jacky4566/KTM1190CruiseController/Pictures/790 Cruise Pinout.jpg

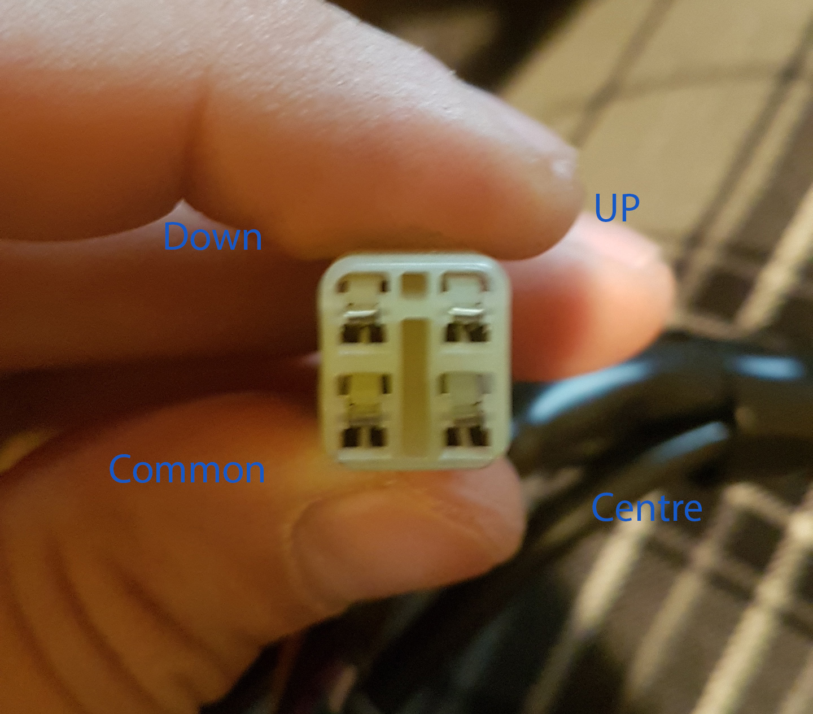
Pictures/790 Cruise Pinout.jpg
