jacky4566/KTM1190CruiseController/Data Sheets/IC/2017-01-09T04_01_26.198Z-Butterfly.sch.png

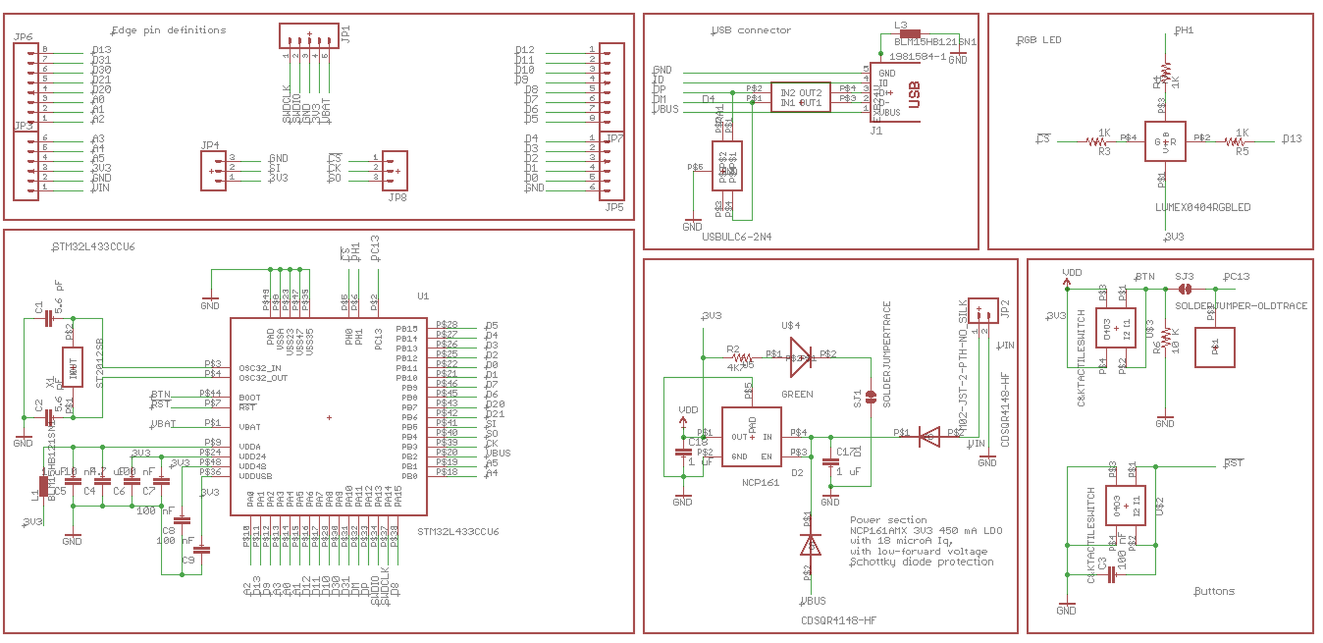
Data Sheets/IC/2017-01-09T04_01_26.198Z-Butterfly.sch.png
