jacky4566/KTM1190CruiseController/Data Sheets/IC/2017-05-11T22_15_35.610Z-ButterflyPinmap.png

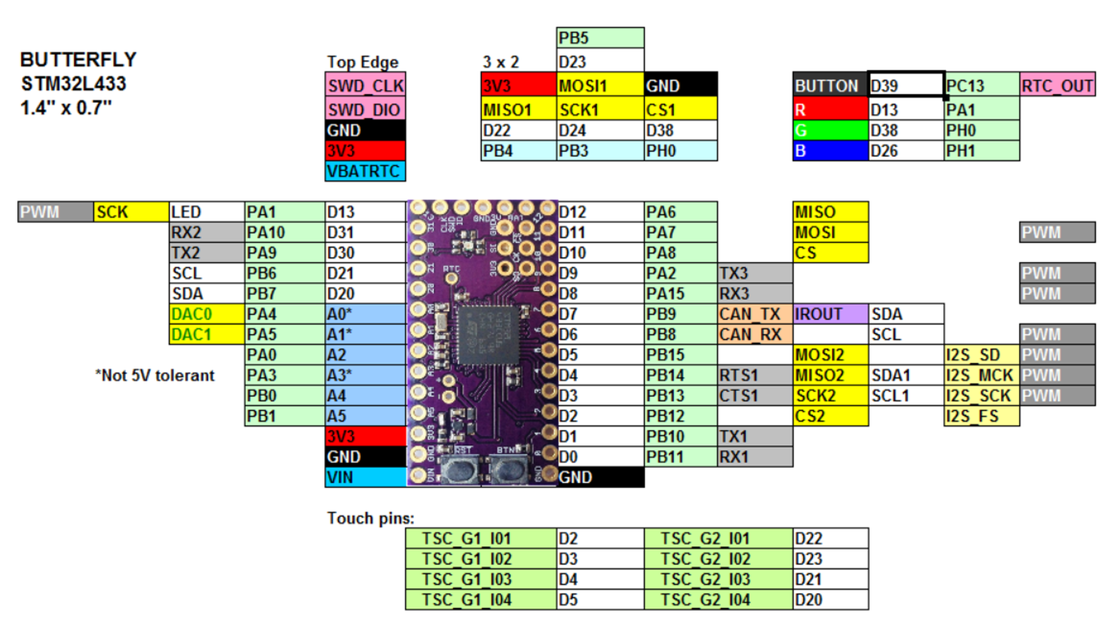
Data Sheets/IC/2017-05-11T22_15_35.610Z-ButterflyPinmap.png
