jacky4566/KTM1190CruiseController/Pictures/1290 Diag connector.png

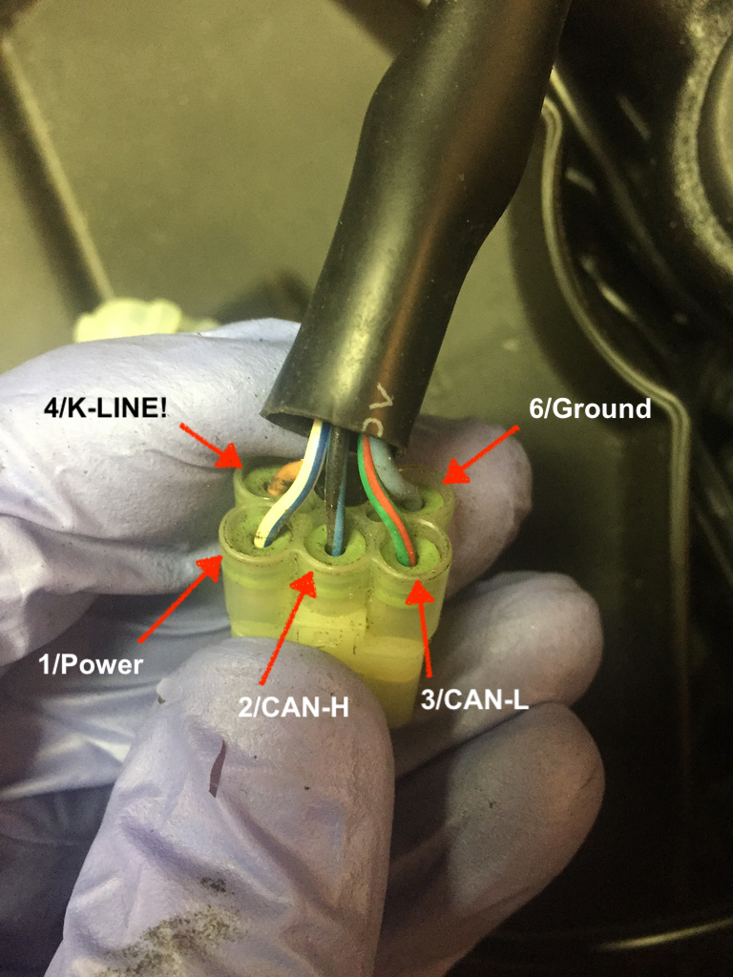
Pictures/1290 Diag connector.png
