jacky4566/KTM1190CruiseController/Pictures/20191111_155026.jpg

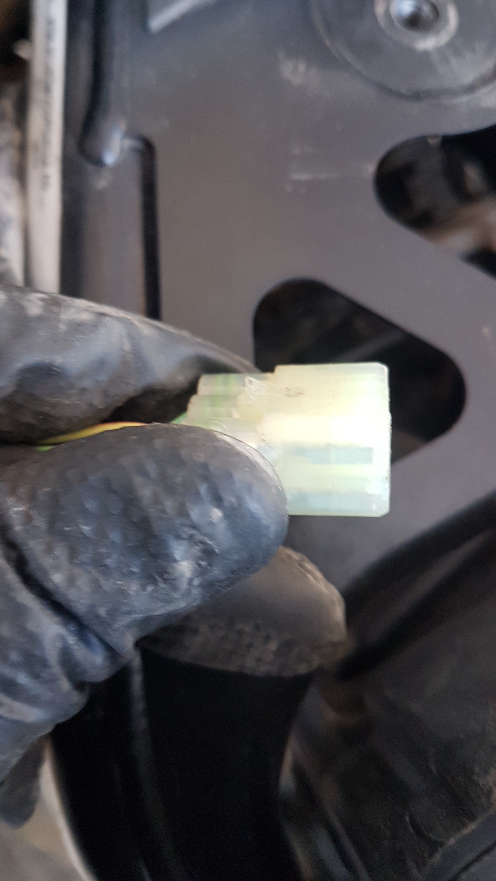
Pictures/20191111_155026.jpg
