jacky4566/KTM1190CruiseController/Pictures/20191111_155047.jpg

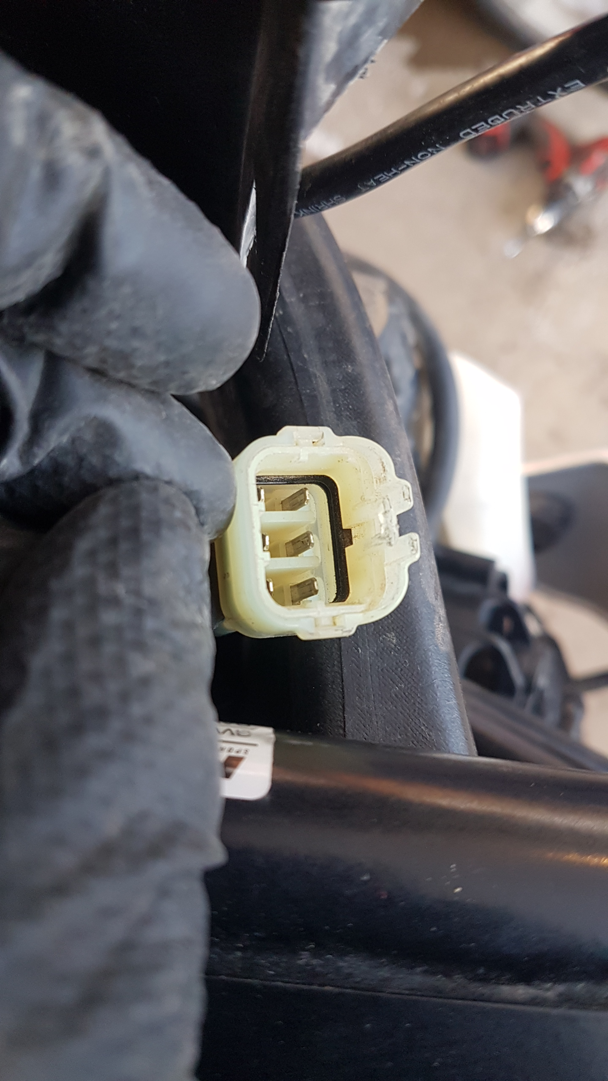
Pictures/20191111_155047.jpg
