jacky4566/KTM1190CruiseController/Pictures/20191111_155336.jpg

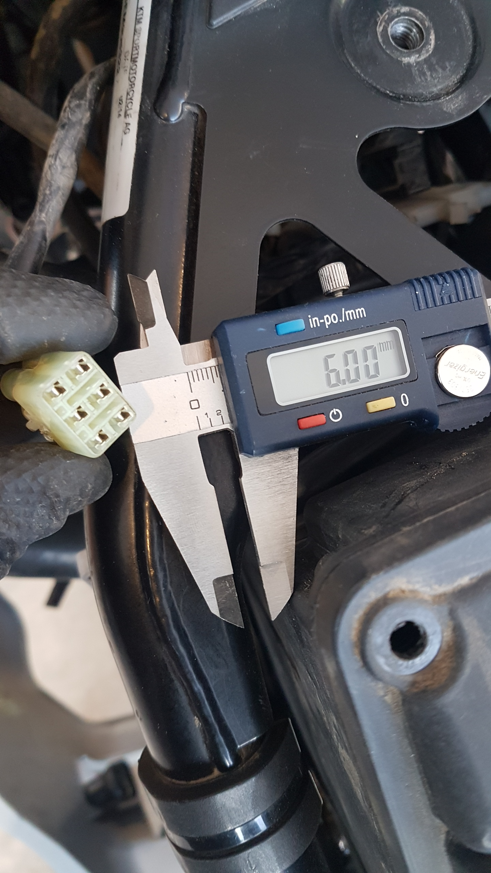
Pictures/20191111_155336.jpg
