jacky4566/KTM1190CruiseController/Pictures/20191111_160846.jpg

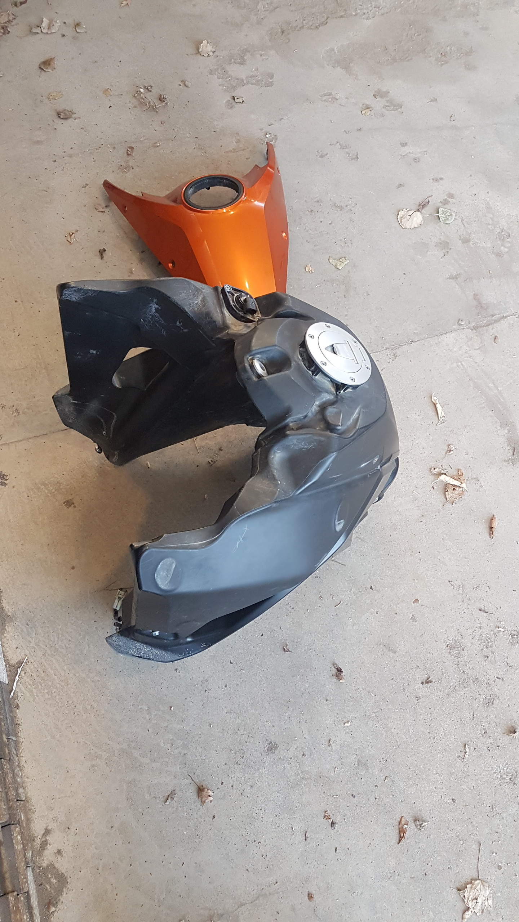
Pictures/20191111_160846.jpg
