jacky4566/KTM1190CruiseController/Pictures/20191112_081033.jpg

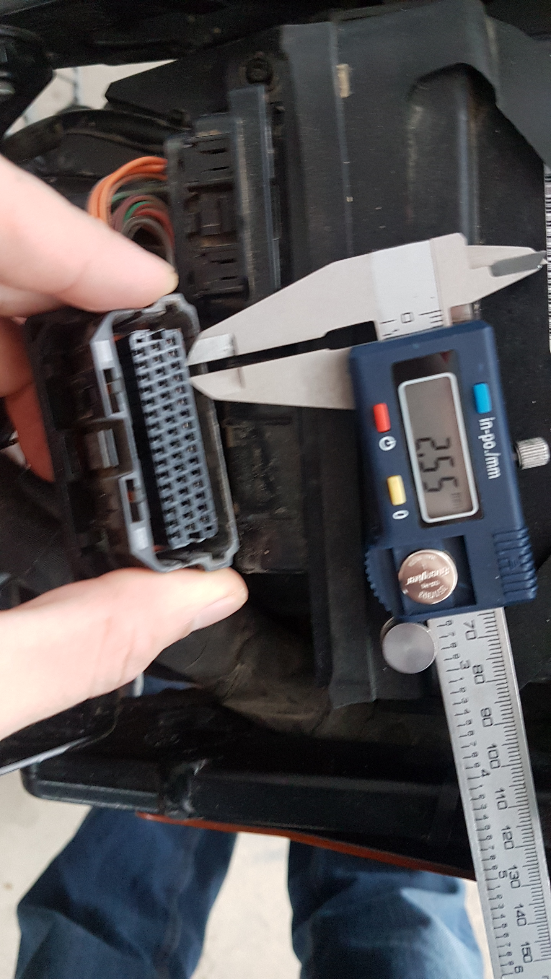
Pictures/20191112_081033.jpg
