jacky4566/KTM1190CruiseController/Pictures/20191113_174318.jpg

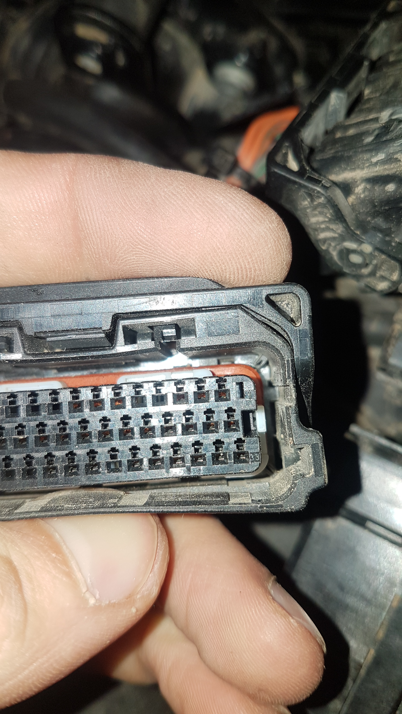
Pictures/20191113_174318.jpg
