jacky4566/KTM1190CruiseController/Pictures/20191113_175318.jpg

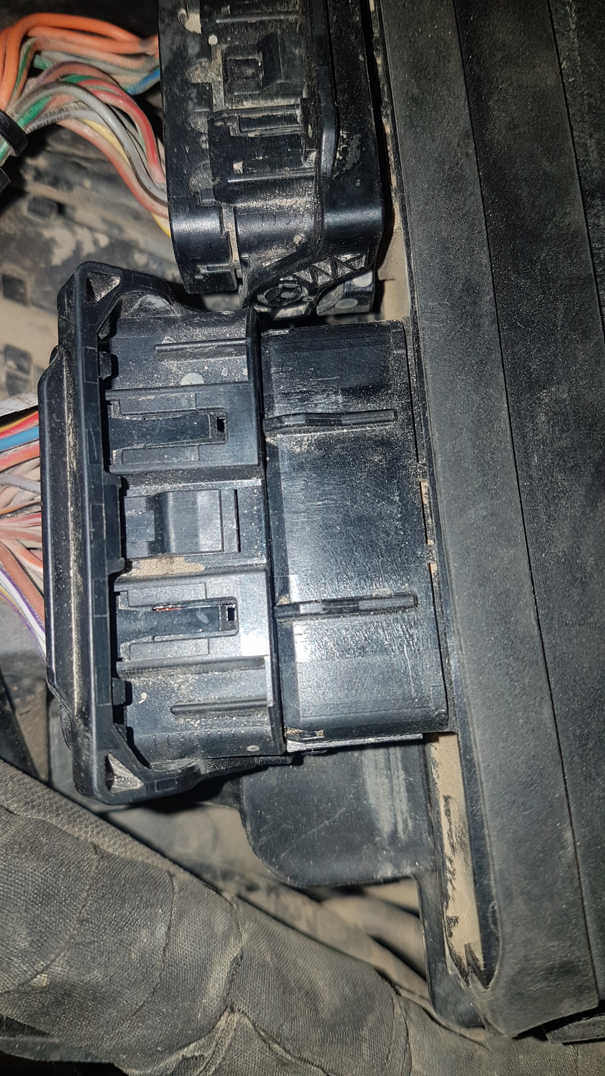
Pictures/20191113_175318.jpg
