jacky4566/KTM1190CruiseController/Pictures/20191124_195120.jpg

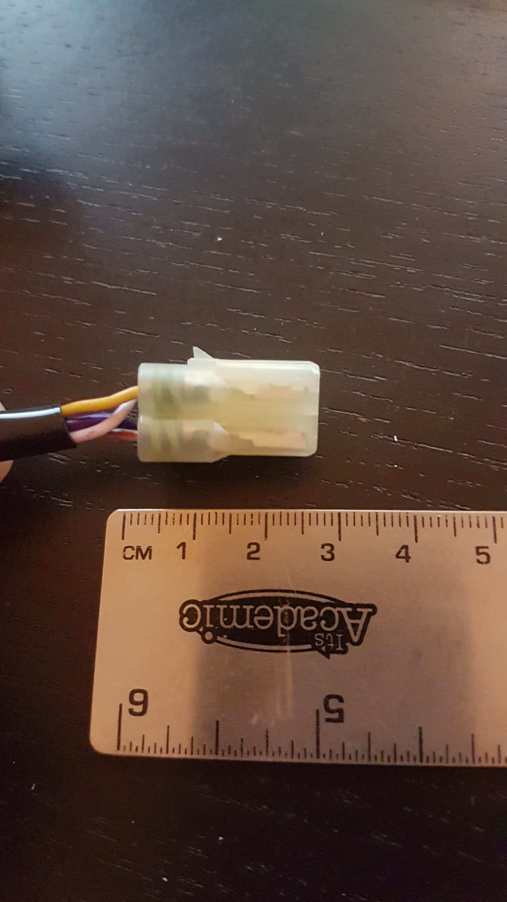
Pictures/20191124_195120.jpg
