jacky4566/KTM1190CruiseController/Pictures/20191124_195130.jpg

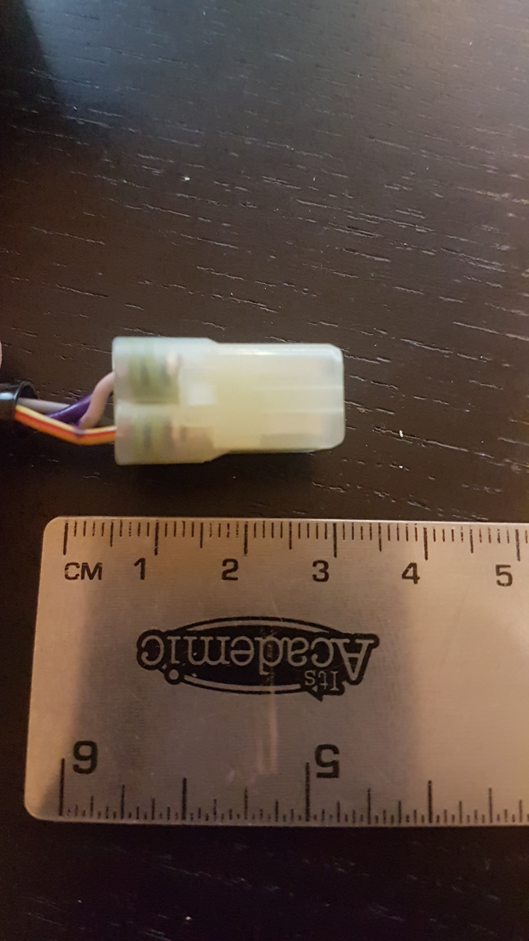
Pictures/20191124_195130.jpg
