jacky4566/KTM1190CruiseController/Pictures/20191222_123456.jpg

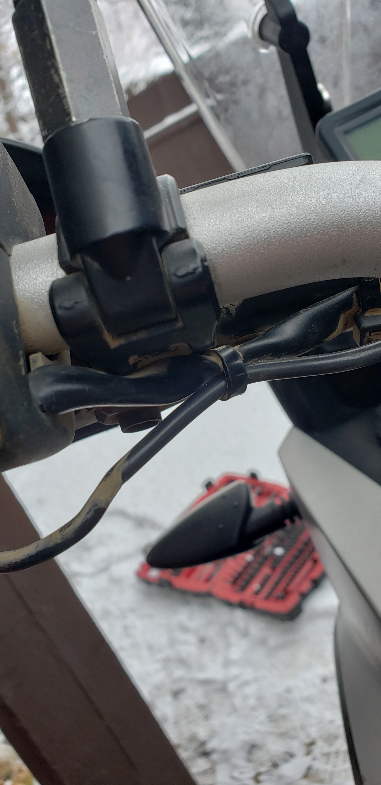
Pictures/20191222_123456.jpg
