jacky4566/KTM1190CruiseController/Pictures/20191222_150725.jpg

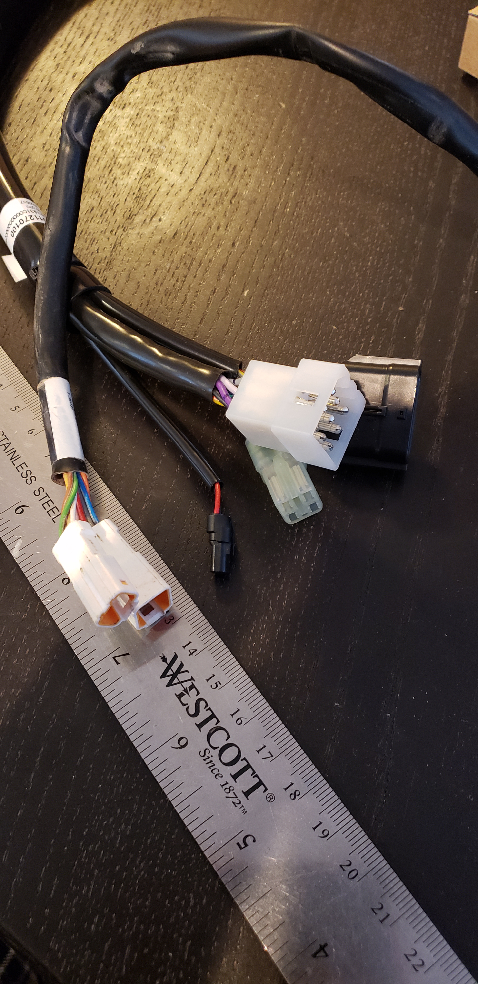
Pictures/20191222_150725.jpg
