jacky4566/KTM1190CruiseController/Pictures/20200411_130119.jpg

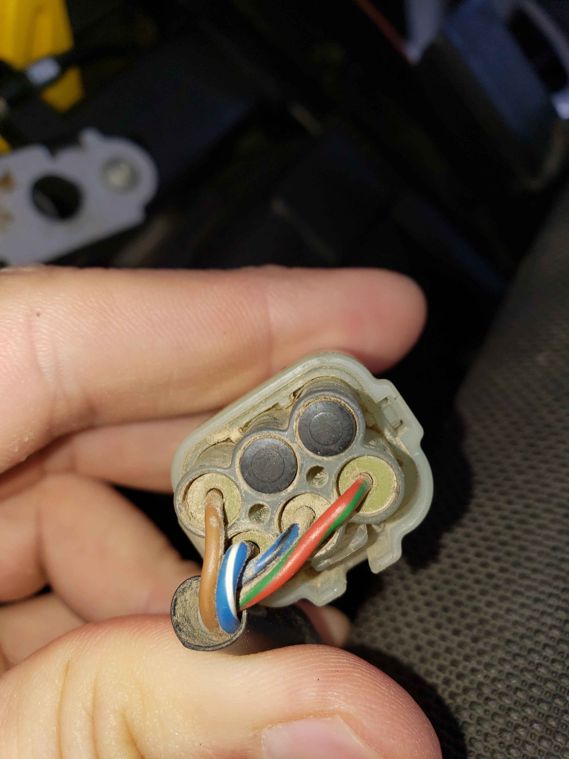
Pictures/20200411_130119.jpg
