jacky4566/KTM1190CruiseController/Pictures/MT-6P-2.jpg

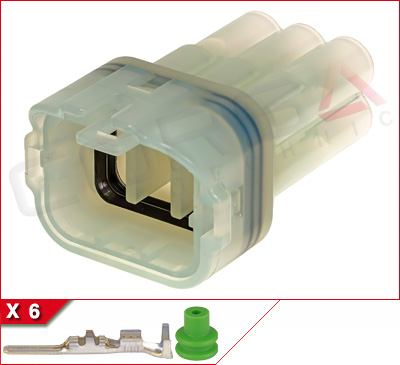
Pictures/MT-6P-2.jpg
