jacky4566/KTM1190CruiseController/Pictures/MT-6S-2.jpg

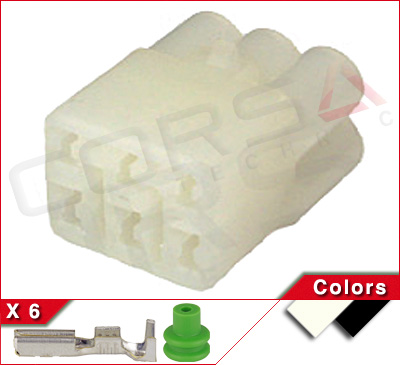
Pictures/MT-6S-2.jpg
