jacky4566/KTM1190CruiseController/Research/KTM_1290_CAN.jpg

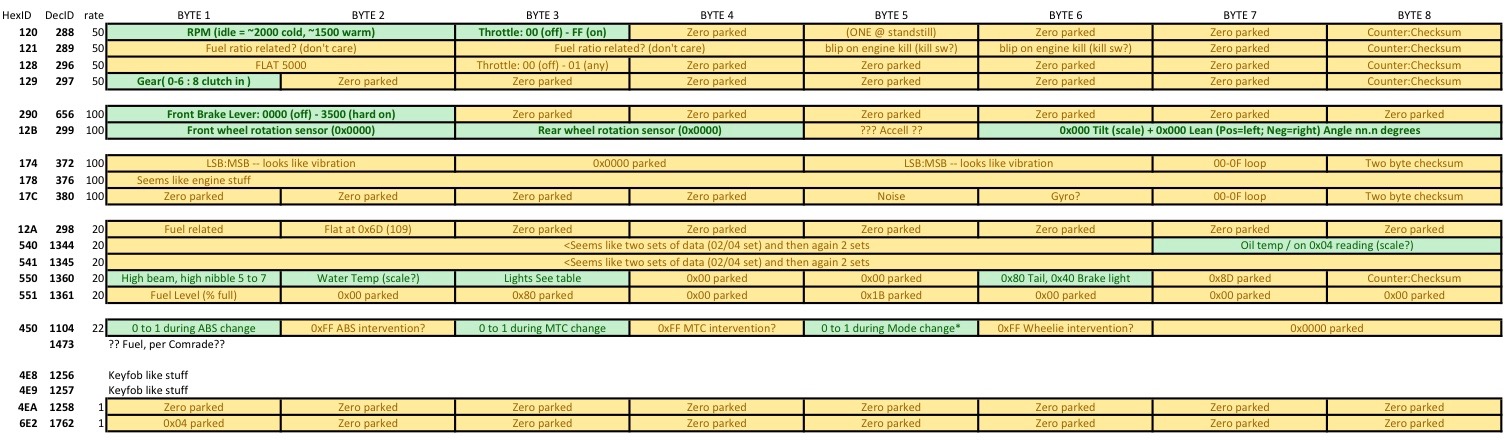
Research/KTM_1290_CAN.jpg
