jacky4566/KTM1190CruiseController/Research/P5120074-X2.jpg

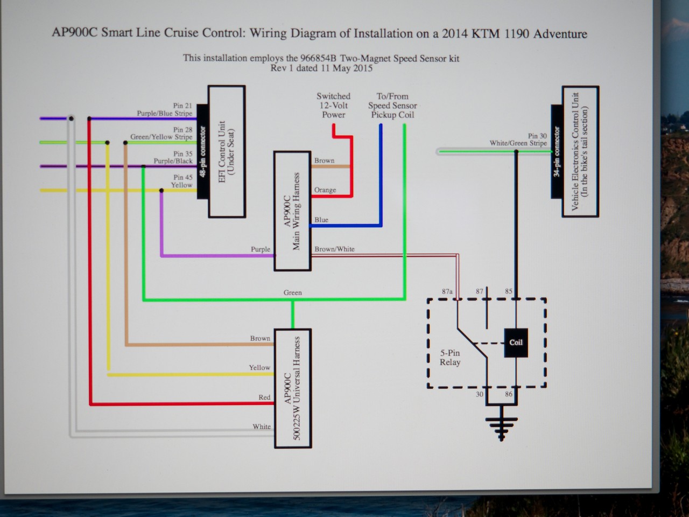
Research/P5120074-X2.jpg
