jacky4566/KTM1190CruiseController/Research/schematic Rev 6.jpg

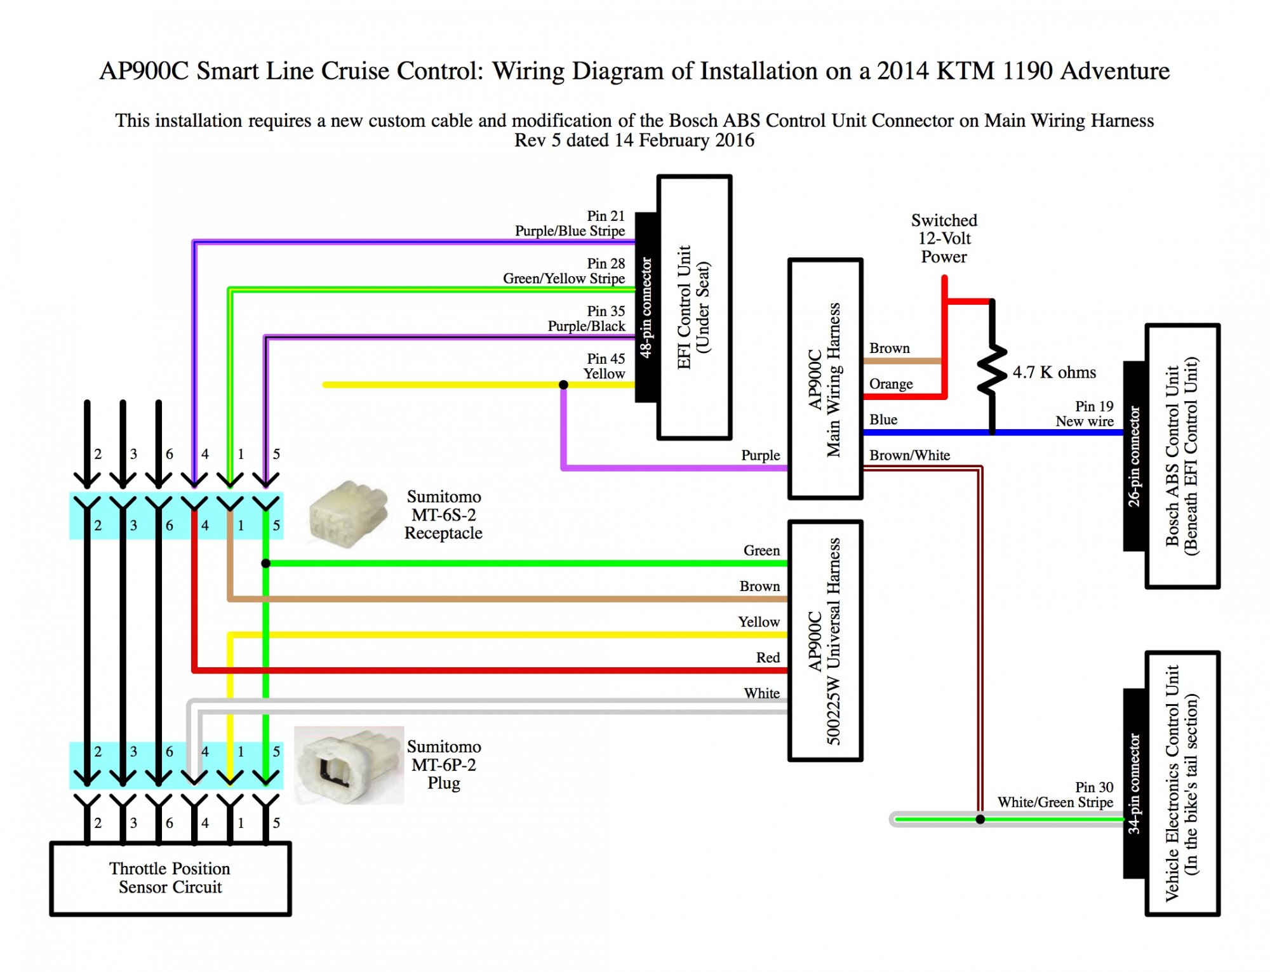
Research/schematic Rev 6.jpg
