jacky4566/KTM1190CruiseController/Board1.0/CruiseController_bom.xlsx

Component | Description | Part | References | Value | Footprint | Quantity Per PCB | Digikey P/N | Cost @10 | Expanded cost | Notes
1 | Unpolarized capacitor, small symbol | C_Small | C1 C2 C3 C7 C9 C14 C15 C18 C20 C21 | 0.1uF | C_0603_1608Metric | 10 | 1276-6582-1-ND | $0.025 | $0.254
2 | Unpolarized capacitor, small symbol | C_Small | C4 C5 C12 C13 C22 | 10nF | C_0603_1608Metric | 5 | 1276-6531-1-ND | $0.049 | $0.245
3 | Unpolarized capacitor, small symbol | C_Small | C6 C8 | 1uF | C_0603_1608Metric | 2 | 1276-6617-1-ND | $0.119 | $0.238
4 | Unpolarized capacitor, small symbol | C_Small | C10 | 4.7uF | C_0805_2012Metric | 1 | 1276-6783-1-ND | $0.360 | $0.360
5 | Unpolarized capacitor, small symbol | C_Small | C16 C17 | 8pF | C_0603_1608Metric | 2 | 1276-6519-1-ND | $0.236 | $0.472
6 |  | 155124M173200-VeridianDesigns | D1 | 155124M173200 | LED_155124M173200 | 1 | 732-11414-1-ND | $0.586 | $0.586
7 | Schottky diode, small symbol | D_Schottky_Small | D2 D3 | D_Schottky_Small | D_SOD-123 | 2 | 497-17154-1-ND | $0.236 | $0.472
8 | Resettable fuse, polymeric positive temperature coefficient, small symbol | Polyfuse_Small | F1 | 200mA | R_1206_3216Metric | 1 | F2109TR-ND | $0.507 | $0.507
9 | Generic connector, double row, 02x09, top/bottom pin numbering scheme (row 1: 1...pins_per_row, row2: pins_per_row+1 ... num_pins), script generated (kicad-library-utils/schlib/autogen/connector/) | Conn_02x09_Top_Bottom | J2 | Conn_02x09_Top_Bottom | MX23A18NF1 | 1 | 670-2462-ND | $10.380 | $10.380
10 | USB Micro Type B connector | USB_B_Micro | J1 | USB_B_Micro | CONN_2173157-3 | 1 | A124356TR-ND | $4.978 | $4.978
11 | Resistor, small symbol | R_Small | R1 R2 R3 R4 R5 R6 R7 R11 R12 R13 R14 | 10k | R_0603_1608Metric | 11 | P10KDBCT-ND | $0.179 | $1.972
12 | Resistor, small symbol | R_Small | R8 | 120 | R_0603_1608Metric | 1 | P120BZCT-ND | $0.145 | $0.145
13 | Resistor, small symbol | R_Small | R15 R16 R17 R26 | 1k | R_0603_1608Metric | 4 | CR0603-JW-102ELFCT-ND | $0.021 | $0.084
14 | Resistor, small symbol | R_Small | R18 R19 R20 | 2.2k | R_0603_1608Metric | 3 | P2.2KGCT-ND | $0.066 | $0.198
15 | Resistor, small symbol | R_Small | R23 R24 | 27 | R_0603_1608Metric | 2 | P27.00BYCT-ND | $0.194 | $0.388
16 | Resistor, small symbol | R_Small | R25 | 75 | R_0603_1608Metric | 1 | P75.0HCT-ND | $0.087 | $0.087
17 | High-Speed CAN Transceiver, 1Mbps, 5V supply, Vio pin, -40C to +125C, DFN8 package | MCP2562-E-MF | U6 | MCP2562-E-MF | DFN-8-1EP_3x3mm_P0.65mm_EP1.55x2.4mm | 1 | MCP2562-E/MF-ND | $1.420 | $1.420
18 |  | MIC5225 | U5 | MIC5225 | SOT-23-5 | 1 | 576-2980-1-ND | $0.600 | $0.600
19 | ARM Cortex-M4 MCU, 256KB flash, 64KB RAM, 80MHz, 1.71-3.6V, 38 GPIO, UFQFPN-48 | STM32L433CCUx | U7 | STM32L433CCUx | QFN-48-1EP_7x7mm_P0.5mm_EP5.6x5.6mm | 1 | 497-16580-ND | $7.828 | $7.828
20 |  | TLV9064IRTER-VeridianDesigns | U3 | TLV9064IRTER | QFN-16-1EP_3x3mm_P0.5mm_EP1.7x1.7mm | 1 | 296-51830-1-ND | $2.166 | $2.166
21 |  | TS5A23157RSER-VeridianDesigns | U4 | TS5A23157RSER | Texas_S-PVSON-N10 | 1 | 296-21919-2-ND | $1.097 | $1.097
22 | Two pin crystal | Crystal | Y1 | 32.768 | Crystal_SMD_G8-2Pin_3.2x1.5mm | 1 | 535-9537-1-ND | $1.215 | $1.215
 |  | Bare Board |  |  |  | 1 |  | $3.160 | $3.160
 |  | Assembly |  |  |  | 1 |  | $15.000 | $15.000
 |  | Assembly shipping |  |  |  | 1 |  | $1.000 | $1.000
 |  |  |  |  |  |  |  |  | $54.853 | Board cost @10
Connectors
1 |  |  |  | HM-4P |  | 1 |  | $3.010 | $3.010
2 |  |  |  | MT-6P-2 |  | 2 |  | $3.130 | $6.260
3 |  |  |  | MT-6S-2 |  | 3 |  | $2.060 | $6.180
4 |  |  | CONN SOCKET HOUSING 18POS | MX23A18SF1 |  | 1 | 670-2463-ND | $7.275 | $7.275
4a |  |  | CONN SOCKET 16-22AWG CRIMP TIN | M23S05K351 |  | 18 | 670-1682-1-ND | $0.153 | $2.754
Wire |  |  |  | 20 AWG |  | 6 |  | $1.000 | $6.000
Sleving |  |  |  | Orange! |  | 4 |  | $0.250 | $1.000
Case and Epoxy |  |  |  |  |  | 1 |  | $2.000 | $2.000
KTM 790 switches |  |  |  | 76011270100 |  | 1 |  | $110.000 | $110.000
 |  |  |  |  |  |  |  |  | $199.332 | CAD
