jacky4566/KTM1190CruiseController/3D files/Ass2.SLDASM

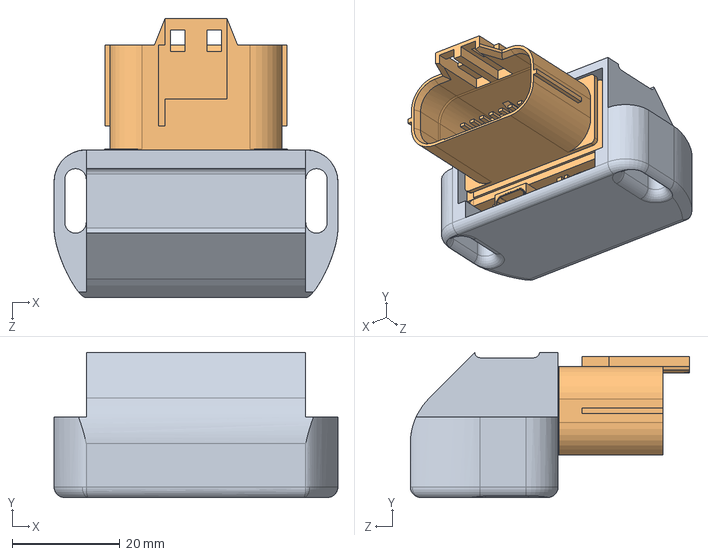
[picture p33: CAD file, 2020-11-22]
3D files/Ass2.SLDASM
52.8 x 27.0 x 51.9 mm
Housing2
PCBv2
