jacky4566/KTM1190CruiseController/3D files/Housing2.SLDPRT

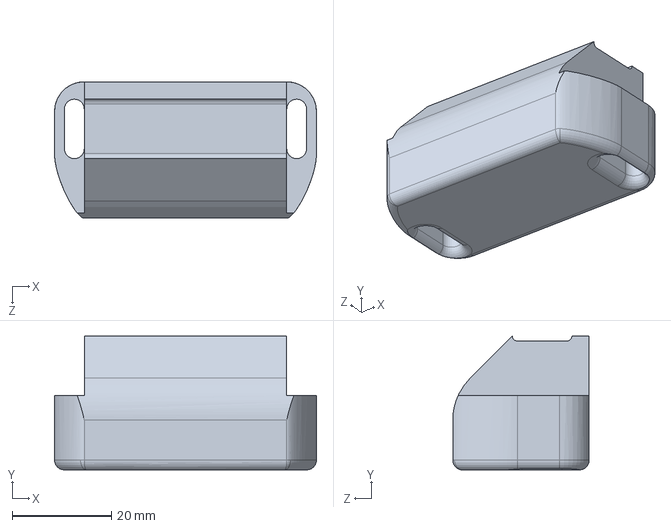
[picture p34: CAD file, 2020-11-22]
3D files/Housing2.SLDPRT
52.8 x 27.0 x 27.5 mm
