jacky4566/KTM1190CruiseController/3D files/PCBv2.SLDPRT

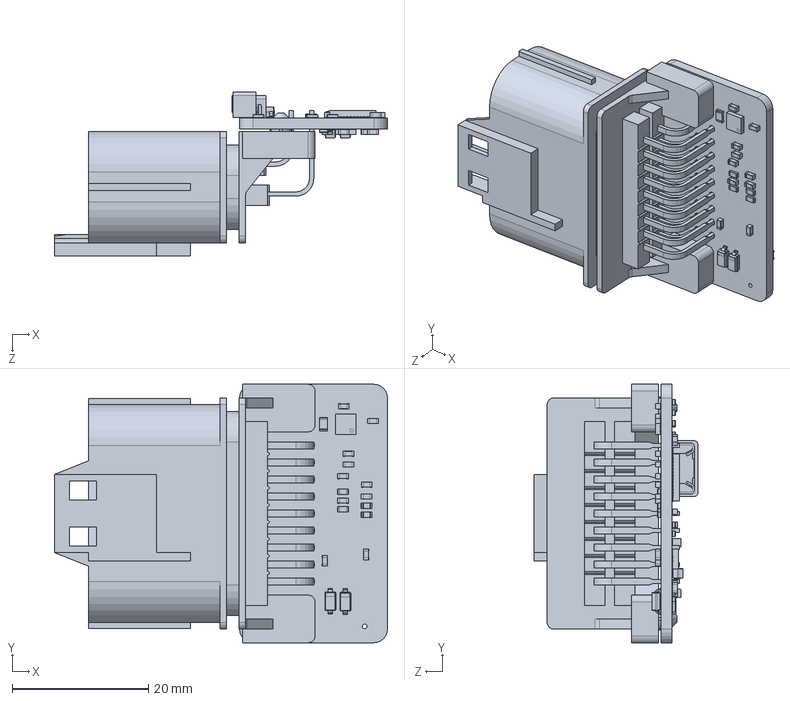
[picture p35: CAD file, 2020-11-22]
3D files/PCBv2.SLDPRT
48.9 x 38.0 x 24.1 mm
