jacky4566/KTM1190CruiseController/3D files/ktm switch hole template.SLDPRT

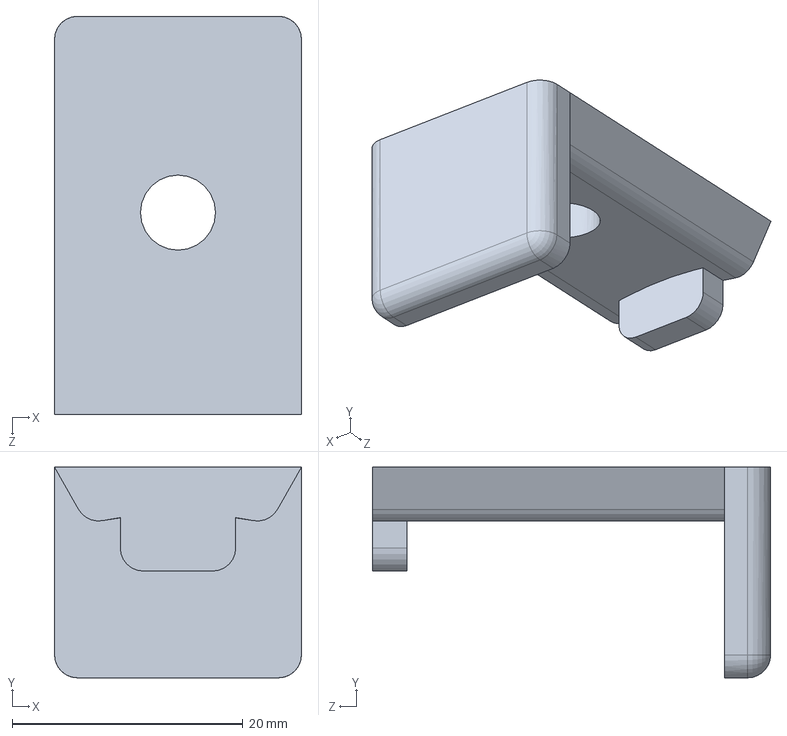
[picture p36: CAD file, 2020-01-10]
3D files/ktm switch hole template.SLDPRT
21.4 x 18.2 x 34.5 mm
