jacky4566/KTM1190CruiseController/3D files/NKK switch.SLDPRT

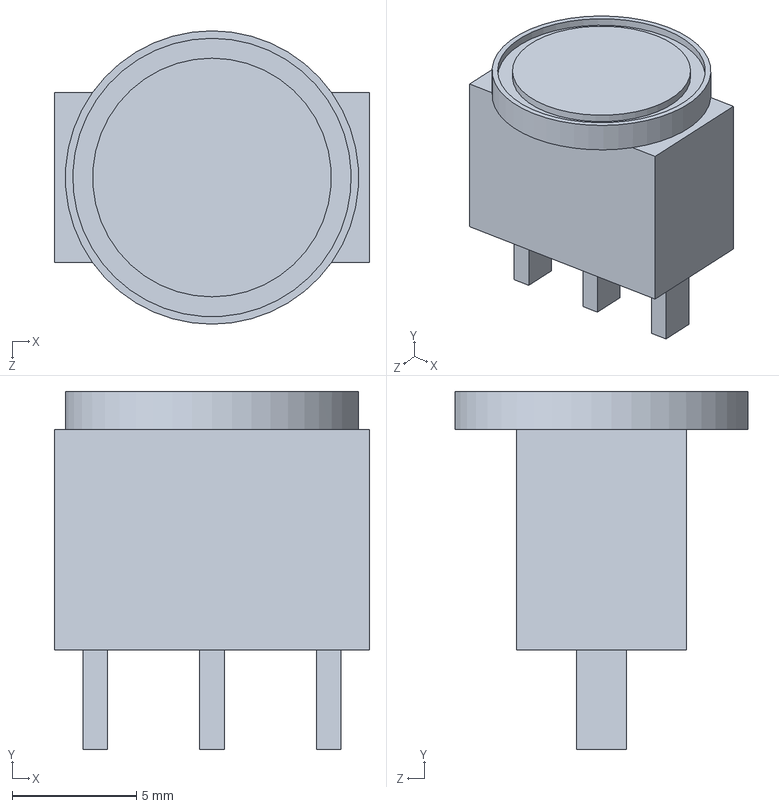
[picture p37: CAD file, 2020-01-10]
3D files/NKK switch.SLDPRT
12.7 x 14.4 x 11.8 mm
