jacky4566/KTM1190CruiseController/(list of files, cad)

Other CAD files:
3D/Housing2.STL
3D/NKK switch.STL
3D/ktm switch hole template.STL
