jacky4566/KTM1190CruiseController/Research/ProgManual_EnglishPage1.jpg

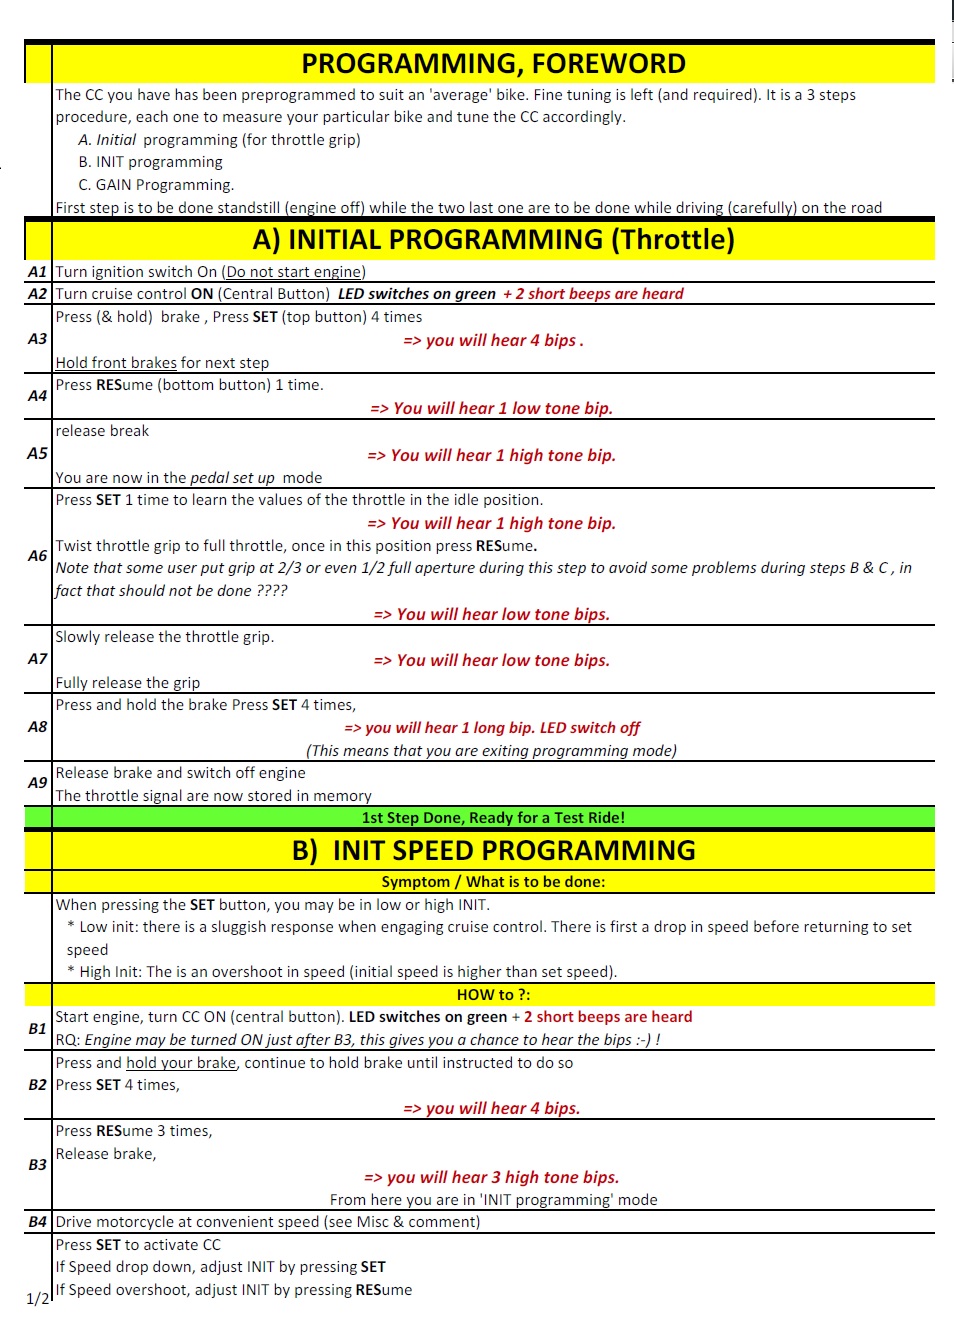
Research/ProgManual_EnglishPage1.jpg
