jacky4566/KTM1190CruiseController/Research/ProgManual_EnglishPage2.jpg

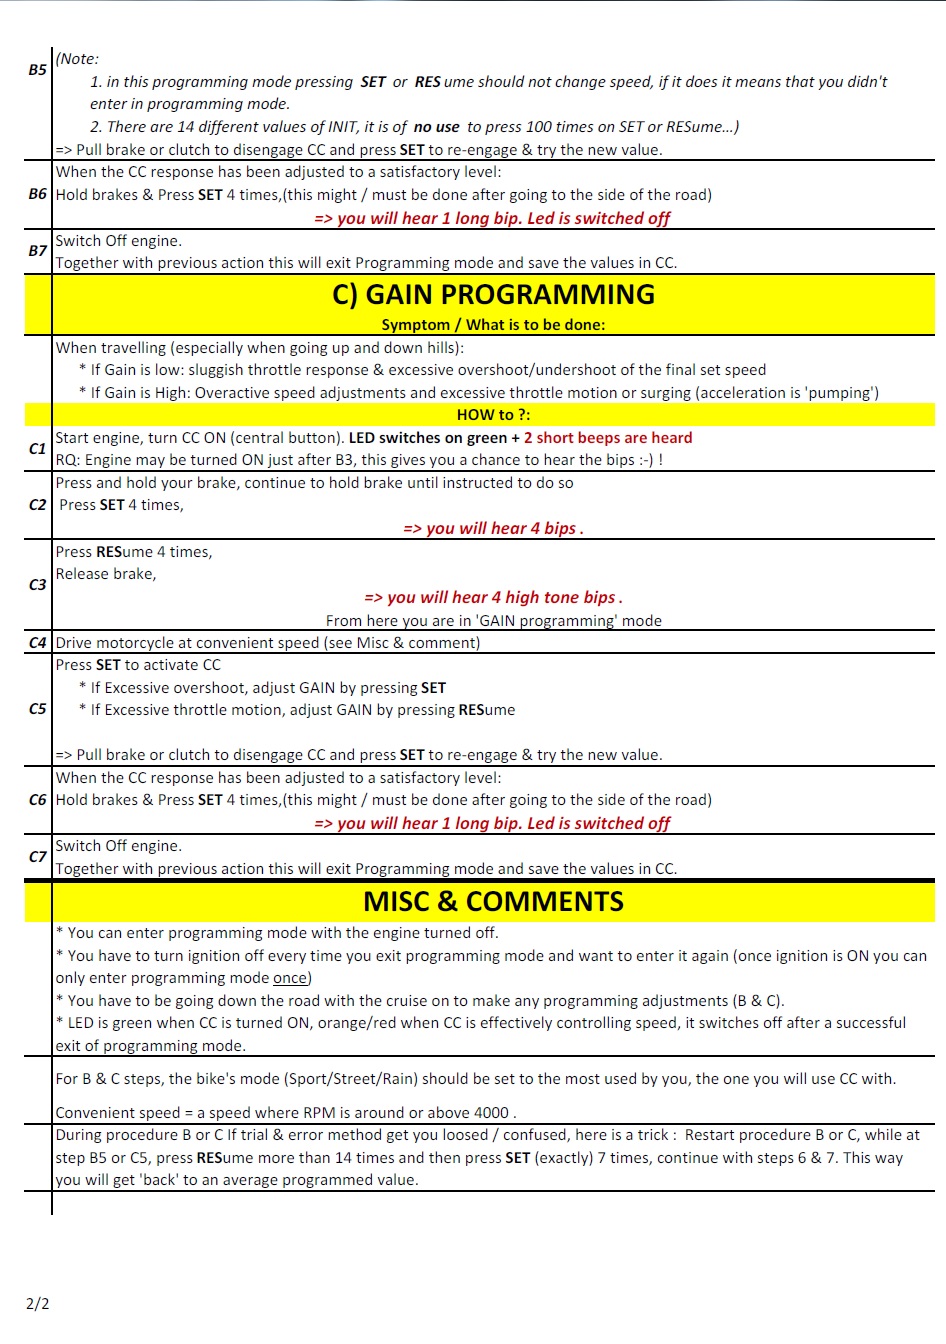
Research/ProgManual_EnglishPage2.jpg
