jacky4566/KTM1190CruiseController/Board4.0/CruiseController.kicad_pcb

## KiCad design Board4.0/CruiseController.kicad_pcb (2020-09-22)

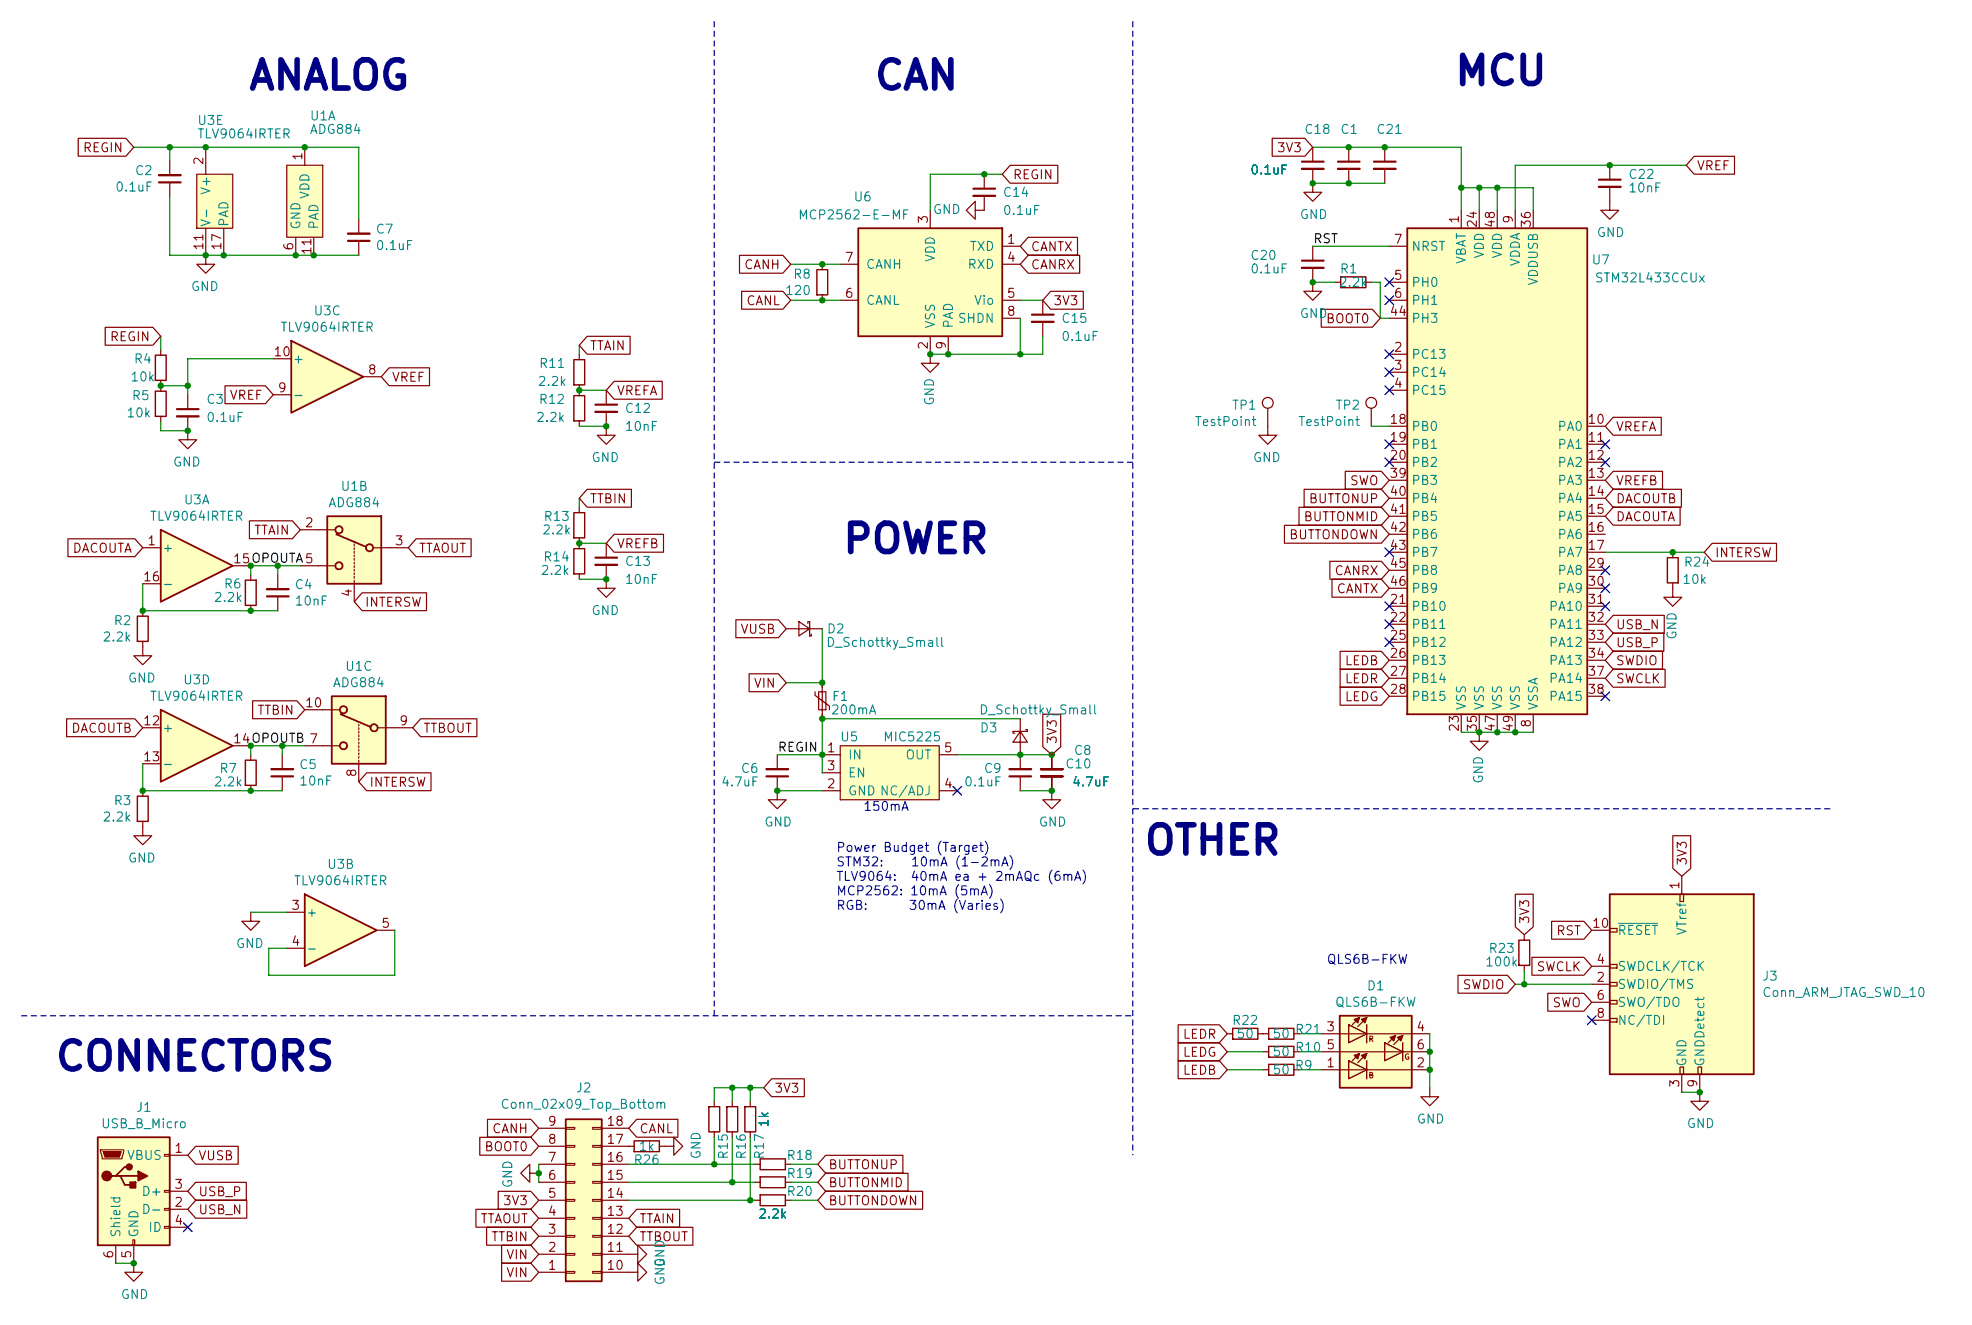
[picture p40: schematic CruiseController.sch]

Parts:
C1, C2, C3, C7, C9, C14, C15, C18, C20, C21: 0.1uF; C_0603_1608Metric
C4, C5, C12, C13, C22: 10nF; C_0603_1608Metric
C6, C8, C10: 4.7uF; C_0805_2012Metric
D1: QLS6B-FKW; LED_Cree-PLCC6_4.7x1.5mm
D2, D3: D_Schottky_Small; D_SOD-323
F1: 200mA; R_1206_3216Metric; Part 1206L020YR
J1: USB_B_Micro; CONN_2173157-3
J2: Conn_02x09_Top_Bottom; MX23A18NF1
J3: Conn_ARM_JTAG_SWD_10; PinHeader_2x05_P1.27mm_Vertical_SMD
R1, R2, R3, R6, R7, R11, R12, R13, R14, R18, R19, R20: 2.2k; R_0603_1608Metric
R4, R5, R24: 10k; R_0603_1608Metric
R8: 120; R_0805_2012Metric
R9, R10, R21, R22: 50; R_0603_1608Metric
R15, R16, R17, R26: 1k; R_0603_1608Metric
R23: 100k; R_0603_1608Metric
TP1: TestPoint; TestPoint_THTPad_D2.0mm_Drill1.0mm
TP2: TestPoint; TestPoint_Pad_1.5x1.5mm
U1: ADG884; Texas_S-PVSON-N10
U3: TLV9064IRTER; QFN-16-1EP_3x3mm_P0.5mm_EP1.7x1.7mm
U5: MIC5225; SOT-23-5
U6: MCP2562-E-MF; DFN-8-1EP_3x3mm_P0.65mm_EP1.55x2.4mm
U7: STM32L433CCUx; QFN-48-1EP_7x7mm_P0.5mm_EP5.6x5.6mm

Connections:
3V3: C1.1, C8.2, C9.2, C10.2, C15.1, C18.1, C21.1, D3.2 (A), J2.5, J3.1 (VTref), R15.1, R16.1, R17.1, R23.2, U5.5 (OUT), U6.5 (Vio), U7.1 (VBAT), U7.24 (VDD), U7.36 (VDDUSB), U7.48 (VDD)
/OPOUTA: C4.2, R6.1, U1.5, U3.15
/OPOUTB: C5.2, R7.2, U1.7, U3.14
BOOT0: J2.8, R1.2, U7.44 (PH3)
BUTTONDOWN: R20.2, U7.42 (PB6)
BUTTONMID: R19.2, U7.41 (PB5)
BUTTONUP: R18.1, U7.40 (PB4)
CANH: J2.9, R8.2, U6.7 (CANH)
CANL: J2.18, R8.1, U6.6 (CANL)
CANRX: U6.4 (RXD), U7.45 (PB8)
CANTX: U6.1 (TXD), U7.46 (PB9)
DACOUTA: U3.1 (+), U7.15 (PA5)
DACOUTB: U3.12 (+), U7.14 (PA4)
GND: C1.2, C2.1, C3.2, C6.1, C7.1, C8.1, C9.1, C10.1, C12.2, C13.2, C14.2, C15.2, C18.2, C20.2, C21.2, C22.2, D1.2 (KB), D1.4 (KR), D1.6 (KR), J1.5 (GND), J1.6 (Shield), J2.6, J2.7, J2.10, J2.11, J3.3 (GND), J3.5 (GND), J3.9 (GNDDetect), R1.1, R2.1, R3.1, R5.1, R12.1, R14.1, R24.1, R26.2, TP1.1, U1.6 (GND), U1.11 (PAD), U3.3 (+), U3.11 (V-), U3.17 (PAD), U5.2 (GND), U6.2 (VSS), U6.8 (SHDN), U6.9 (PAD), U7.8 (VSSA), U7.23 (VSS), U7.35 (VSS), U7.47 (VSS), U7.49 (VSS)
INTERSW: R24.2, U1.4, U1.8, U7.17 (PA7)
LEDB: R9.1, U7.26 (PB13)
LEDG: R10.1, U7.28 (PB15)
LEDR: R22.1, U7.27 (PB14)
unnamed: C3.1, R4.1, R5.2, U3.10 (+)
unnamed: C4.1, R2.2, R6.2, U3.16 (-)
unnamed: C5.1, R3.2, R7.1, U3.13 (-)
unnamed: D1.1 (AB), R9.2
unnamed: D1.3 (AR), R21.2
unnamed: D1.5 (AG), R10.2
unnamed: J2.14, R17.2, R20.1
unnamed: J2.15, R16.2, R19.1
unnamed: J2.16, R15.2, R18.2
unnamed: J2.17, R26.1
unnamed: R21.1, R22.2
unnamed: TP2.1, U7.18 (PB0)
unnamed: U3.4 (-), U3.5
REGIN: C2.2, C6.2, C7.2, C14.1, D3.1 (K), F1.1, R4.2, U1.1 (VDD), U3.2 (V+), U5.1 (IN), U5.3 (EN), U6.3 (VDD)
RST: C20.1, J3.10 (~RESET~), U7.7 (NRST)
SWCLK: J3.4 (SWDCLK/TCK), U7.37 (PA14)
SWDIO: J3.2 (SWDIO/TMS), R23.1, U7.34 (PA13)
SWO: J3.6 (SWO/TDO), U7.39 (PB3)
TTAIN: J2.13, R11.2, U1.2
TTAOUT: J2.4, U1.3
TTBIN: J2.3, R13.2, U1.10
TTBOUT: J2.12, U1.9
USB_N: J1.2 (D-), U7.32 (PA11)
USB_P: J1.3 (D+), U7.33 (PA12)
VIN: D2.1 (K), F1.2, J2.1, J2.2
VREF: C22.1, U3.8, U3.9 (-), U7.9 (VDDA)
VREFA: C12.1, R11.1, R12.2, U7.10 (PA0)
VREFB: C13.1, R13.1, R14.2, U7.13 (PA3)
VUSB: D2.2 (A), J1.1 (VBUS)

Notes on the sheet:
150mA
Power Budget (Target) STM32: 10mA (1-2mA) TLV9064: 40mA ea + 2mAQc (6mA) MCP2562: 10mA (5mA) RGB: 30mA (Varies)
ANALOG
POWER
CAN
MCU
CONNECTORS
OTHER
QLS6B-FKW

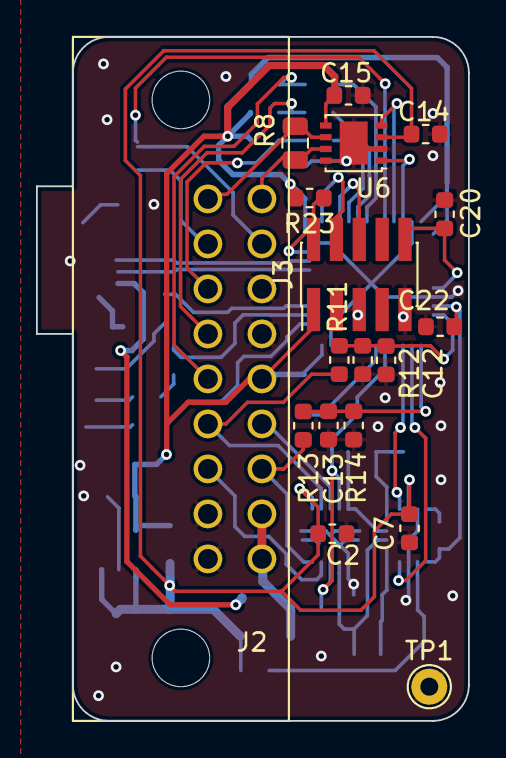
[picture p41: board Board4.0/CruiseController.kicad_pcb from above]

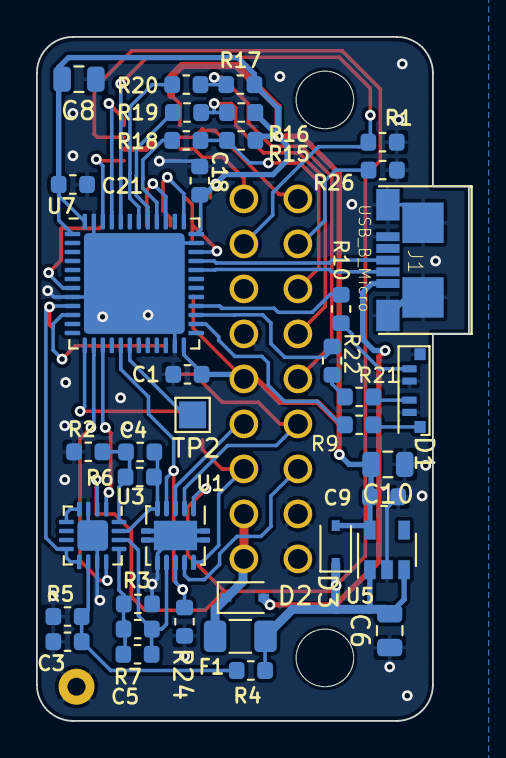
[picture p42: board Board4.0/CruiseController.kicad_pcb from below]

Board: 2 copper layers, 24.0 x 38.0 mm, 57 parts (39 on the bottom side), 47 nets.
