jacky4566/KTM1190CruiseController/Board1.0/CruiseController.kicad_pcb

## KiCad design Board1.0/CruiseController.kicad_pcb (2019-12-08)

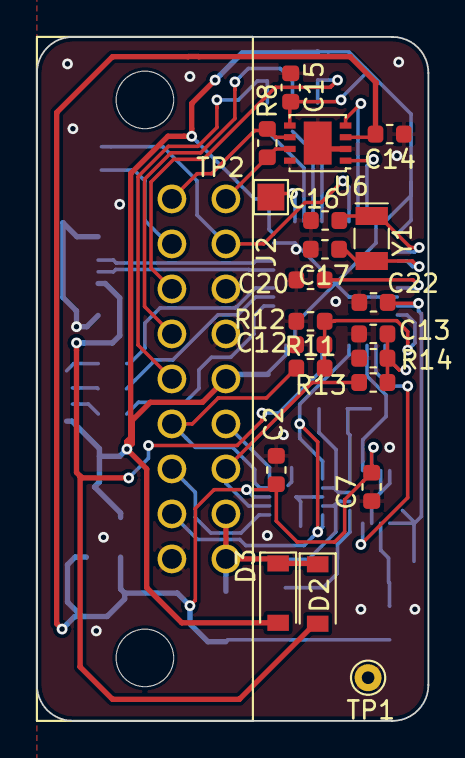
[picture p43: board Board1.0/CruiseController.kicad_pcb from above]

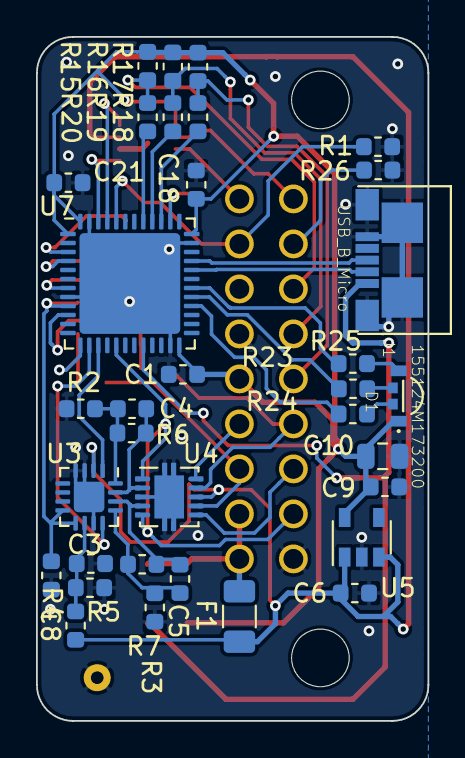
[picture p44: board Board1.0/CruiseController.kicad_pcb from below]

Board: 2 copper layers, 21.8 x 38.0 mm, 56 parts (34 on the bottom side), 44 nets.

Parts:
C1, C2, C3, C7, C9, C14, C15, C18, C20, C21: 0.1uF; C_0603_1608Metric
C4, C5, C12, C13, C22: 10nF; C_0603_1608Metric
C6, C8: 1uF; C_0603_1608Metric
C10: 4.7uF; C_0805_2012Metric
C16, C17: 8pF; C_0603_1608Metric
D1: 155124M173200; LED_155124M173200
D2, D3: D_Schottky_Small; D_SOD-123
F1: 200mA; R_1206_3216Metric
J1: USB_B_Micro; CONN_2173157-3
J2: Conn_02x09_Top_Bottom; MX23A18NF1
R1, R2, R3, R4, R5, R6, R7, R11, R12, R13, R14: 10k; R_0603_1608Metric
R8: 120; R_0603_1608Metric
R15, R16, R17, R26: 1k; R_0603_1608Metric
R18, R19, R20: 2.2k; R_0603_1608Metric
R23, R24: 27; R_0603_1608Metric
R25: 75; R_0603_1608Metric
TP1: TestPoint; TestPoint_THTPad_D1.5mm_Drill0.7mm
TP2: TestPoint; TestPoint_Pad_1.5x1.5mm
U3: TLV9064IRTER; QFN-16-1EP_3x3mm_P0.5mm_EP1.7x1.7mm
U4: TS5A23157RSER; Texas_S-PVSON-N10
U5: MIC5225; SOT-23-5
U6: MCP2562-E-MF; DFN-8-1EP_3x3mm_P0.65mm_EP1.55x2.4mm
U7: STM32L433CCUx; QFN-48-1EP_7x7mm_P0.5mm_EP5.6x5.6mm
Y1: 32.768; Crystal_SMD_G8-2Pin_3.2x1.5mm

Connections:
3V3: C1.1, C9.2, C10.2, C15.1, C18.1, C21.1, D1.1, D3.2, J2.5, R15.2, R16.2, R17.2, U5.5, U6.5, U7.1, U7.24, U7.36, U7.48
/RST: C20.1, U7.7
/USB_N: J1.2, U7.32
/USB_P: J1.3, U7.33
BOOT0: J2.8, R1.2, U7.44
BUTTONDOWN: R20.2, U7.39
BUTTONMID: R19.2, U7.40
BUTTONUP: R18.1, U7.41
CANH: J2.9, R8.2, U6.7
CANL: J2.18, R8.1, U6.6
CANRX: U6.4, U7.45
CANTX: U6.1, U7.46
DACOUTA: U3.1, U7.15
DACOUTB: U3.12, U7.14
GND: C1.2, C2.1, C3.2, C6.1, C7.1, C8.2, C9.1, C10.1, C12.2, C13.2, C14.2, C15.2, C16.1, C17.1, C18.2, C20.2, C21.2, C22.2, J1.5, J1.6, J2.6, J2.7, J2.10, R1.1, R2.1, R3.1, R5.1, R12.1, R14.1, R26.2, TP1.1, U3.3, U3.4, U3.11, U3.17, U4.3, U4.11, U5.2, U6.2, U6.8, U6.9, U7.8, U7.23, U7.35, U7.47, U7.49
INTERSW: J2.11, U4.1, U4.5, U7.17
LED1: R24.1, U7.28
LED2: R23.1, U7.29
LED3: R25.1, U7.30
unnamed: C3.1, R4.1, R5.2, U3.10
unnamed: C4.1, R2.2, R6.2, U3.16
unnamed: C4.2, R6.1, U3.15, U4.2
unnamed: C5.1, R3.2, R7.1, U3.13
unnamed: C5.2, R7.2, U3.14, U4.4
unnamed: C16.2, U7.3, Y1.1
unnamed: C17.2, U7.4, Y1.2
unnamed: D1.2, R24.2
unnamed: D1.3, R23.2
unnamed: D1.4, R25.2
unnamed: J2.14, R17.1, R20.1
unnamed: J2.15, R16.1, R19.1
unnamed: J2.16, R15.1, R18.2
unnamed: J2.17, R26.1
unnamed: TP2.1, U7.38
REGIN: C2.2, C6.2, C7.2, C14.1, F1.1, R4.2, U3.2, U4.8, U5.1, U5.3, U6.3
TTAIN: J2.13, R11.2, U4.9
TTAOUT: J2.4, U4.10
TTBIN: J2.3, R13.2, U4.7
TTBOUT: J2.12, U4.6
VIN: D2.1, D3.1, F1.2, J2.1, J2.2
VREF: C8.1, C22.1, U3.8, U3.9, U7.9
VREFA: C12.1, R11.1, R12.2, U7.10
VREFB: C13.1, R13.1, R14.2, U7.13
VUSB: D2.2, J1.1, U7.20
