jacky4566/KTM1190CruiseController/Firmware/LEDTEST/Core/Src/main.c

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
/* Includes ------------------------------------------------------------------*/
#include "main.h"
#include "usb_device.h"

ADC_HandleTypeDef hadc1;

DAC_HandleTypeDef hdac1;

RTC_HandleTypeDef hrtc;

void SystemClock_Config(void);
static void MX_GPIO_Init(void);
static void MX_ADC1_Init(void);
static void MX_DAC1_Init(void);
static void MX_RTC_Init(void);
/**
  * @brief  The application entry point.
  * @retval int
  */
int main(void)
{
  /* MCU Configuration--------------------------------------------------------*/

  /* Reset of all peripherals, Initializes the Flash interface and the Systick. */
  HAL_Init();

  /* Configure the system clock */
  SystemClock_Config();

  /* Initialize all configured peripherals */
  MX_GPIO_Init();
  MX_USB_DEVICE_Init();
  MX_ADC1_Init();
  MX_DAC1_Init();
  MX_RTC_Init();
  /* USER CODE BEGIN 2 */
  uint8_t buffer[20];

  /* USER CODE END 2 */

  /* Infinite loop */
  /* USER CODE BEGIN WHILE */
  while (1)
  {
	  HAL_GPIO_WritePin(LEDB_GPIO_Port, LEDB_Pin, 1);
	  strcpy(buffer,"B\r\n");
	  CDC_Transmit_FS(buffer, sizeof(buffer));
	  HAL_Delay(500);
	  HAL_GPIO_WritePin(LEDB_GPIO_Port, LEDB_Pin, 0);
	  HAL_Delay(500);

	  HAL_GPIO_WritePin(LEDR_GPIO_Port, LEDR_Pin, 1);
	  strcpy(buffer,"R\r\n");
	  CDC_Transmit_FS(buffer, sizeof(buffer));
	  HAL_Delay(500);
	  HAL_GPIO_WritePin(LEDR_GPIO_Port, LEDR_Pin, 0);
	  HAL_Delay(500);

	  HAL_GPIO_WritePin(LEDG_GPIO_Port, LEDG_Pin, 1);
	  strcpy(buffer,"G\r\n");
	  CDC_Transmit_FS(buffer, sizeof(buffer));
	  HAL_Delay(500);
	  HAL_GPIO_WritePin(LEDG_GPIO_Port, LEDG_Pin, 0);
	  HAL_Delay(500);
	  /* USER CODE END WHILE */

    /* USER CODE BEGIN 3 */
  }
  /* USER CODE END 3 */
}

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
/* USER CODE BEGIN 4 */
void HAL_Delay(uint32_t Delay)
{
  uint32_t tickstart = HAL_GetTick();
  uint32_t wait = Delay;

  /* Add a period to guaranty minimum wait */
  if (wait < HAL_MAX_DELAY)
  {
    wait += (uint32_t)uwTickFreq;
  }

  while ((HAL_GetTick() - tickstart) < wait)
  {
	  __WFI();
  }
}


/* USER CODE END 4 */
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
