jacky4566/KTM1190CruiseController/Firmware/LEDTEST/LEDTEST.ioc

Mcu.UserName=STM32L433CCUx
PA0.GPIO_Label=ADC_VREFA
PA0.Signal=ADCx_IN5
PA11.Signal=USB_DM
PA12.Signal=USB_DP
PA3.GPIO_Label=ADC_VREFB
PA3.Signal=ADCx_IN8
PA4.Signal=COMP_DAC11_group
PA5.Signal=COMP_DAC12_group
PB13.GPIO_Label=LEDB
PB13.Signal=GPIO_Output
PB14.GPIO_Label=LEDR
PB14.Signal=GPIO_Output
PB15.GPIO_Label=LEDG
PB15.Signal=GPIO_Output
