jacky4566/KTM1190CruiseController/Firmware/LEDTEST/Core/Inc/main.h

#define ADC_VREFA_Pin GPIO_PIN_0
#define ADC_VREFA_GPIO_Port GPIOA
#define ADC_VREFB_Pin GPIO_PIN_3
#define ADC_VREFB_GPIO_Port GPIOA
#define LEDB_Pin GPIO_PIN_13
#define LEDB_GPIO_Port GPIOB
#define LEDR_Pin GPIO_PIN_14
#define LEDR_GPIO_Port GPIOB
#define LEDG_Pin GPIO_PIN_15
#define LEDG_GPIO_Port GPIOB
