jacky4566/KTM1190CruiseController/(commit log)

2019-12-08 Updated BOM
    [CruiseController_bom.xlsx, CruiseController_bom_.csv, CruiseController_bom_.xlsx]
2019-12-08 Create 1290 Diag connector.png
2019-12-09 Board V2
    [CruiseController.kicad_pcb, CruiseController.sch, Housing2.STL, S48B-ZROK-2A-R.STEP]
2019-12-09 V2 replace LED
    [CruiseController.kicad_pcb, CruiseController.sch]
2019-12-10 Update V2
    increase usb area
    [CruiseController.kicad_pcb]
2019-12-10 Added canbus library for stm32
2019-12-14 testing dac dma. work on V01
2019-12-19 udpate v2 pcb
    [CruiseController.kicad_pcb, CruiseController.sch]
2019-12-19 pcb v2
    [CruiseController.sch]
2019-12-19 update pcbv2
    [CruiseController.kicad_pcb, CruiseController.sch]
2019-12-22 submit board 2 for quote
    [BOM.xlsx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]
2019-12-23 update pcb v2
    [CruiseController-B_Cu.gbr, CruiseController-B_Mask.gbr, CruiseController-B_Paste.gbr, CruiseController-B_SilkS.gbr, CruiseController-Edge_Cuts.gbr, CruiseController-F_Cu.gbr, CruiseController-F_Mask.gbr, CruiseController-F_Paste.gbr]
2019-12-27 start pcb v3
    [CruiseController.kicad_pcb, CruiseController.sch]
2020-01-05 Draw v3
    [CruiseController.kicad_pcb, CruiseController.sch]
2020-01-10 add swtich templates
    [NKK switch.SLDPRT, NKK switch.STL, ktm switch hole template.SLDPRT, ktm switch hole template.STL]
2020-01-10 fix LED PWM pins
    [CruiseController.kicad_pcb]
2020-03-20 Update v3
    [CruiseController.kicad_pcb, CruiseController.sch]
2020-06-09 Geber Files
    [CruiseController-B_Cu.gbr, CruiseController-B_Mask.gbr, CruiseController-B_Paste.gbr, CruiseController-B_SilkS.gbr, CruiseController-Edge_Cuts.gbr, CruiseController-F_Cu.gbr, CruiseController-F_Mask.gbr, CruiseController-F_Paste.gbr]
2020-09-22 Board 4.0
    [CruiseController.kicad_pcb, CruiseController.sch]
2020-09-22 Switch to STM32CUBEIDE
2020-11-22 Add 3d files
    [Ass2.SLDASM, Housing2.SLDPRT, NKK switch.SLDPRT, PCBv2.SLDPRT, ktm switch hole template.SLDPRT]
